lhr-solar/RTD_Array_Board/RTDTemp.kicad_sch

## KiCad design RTDTemp.kicad_sch (2022-02-08)

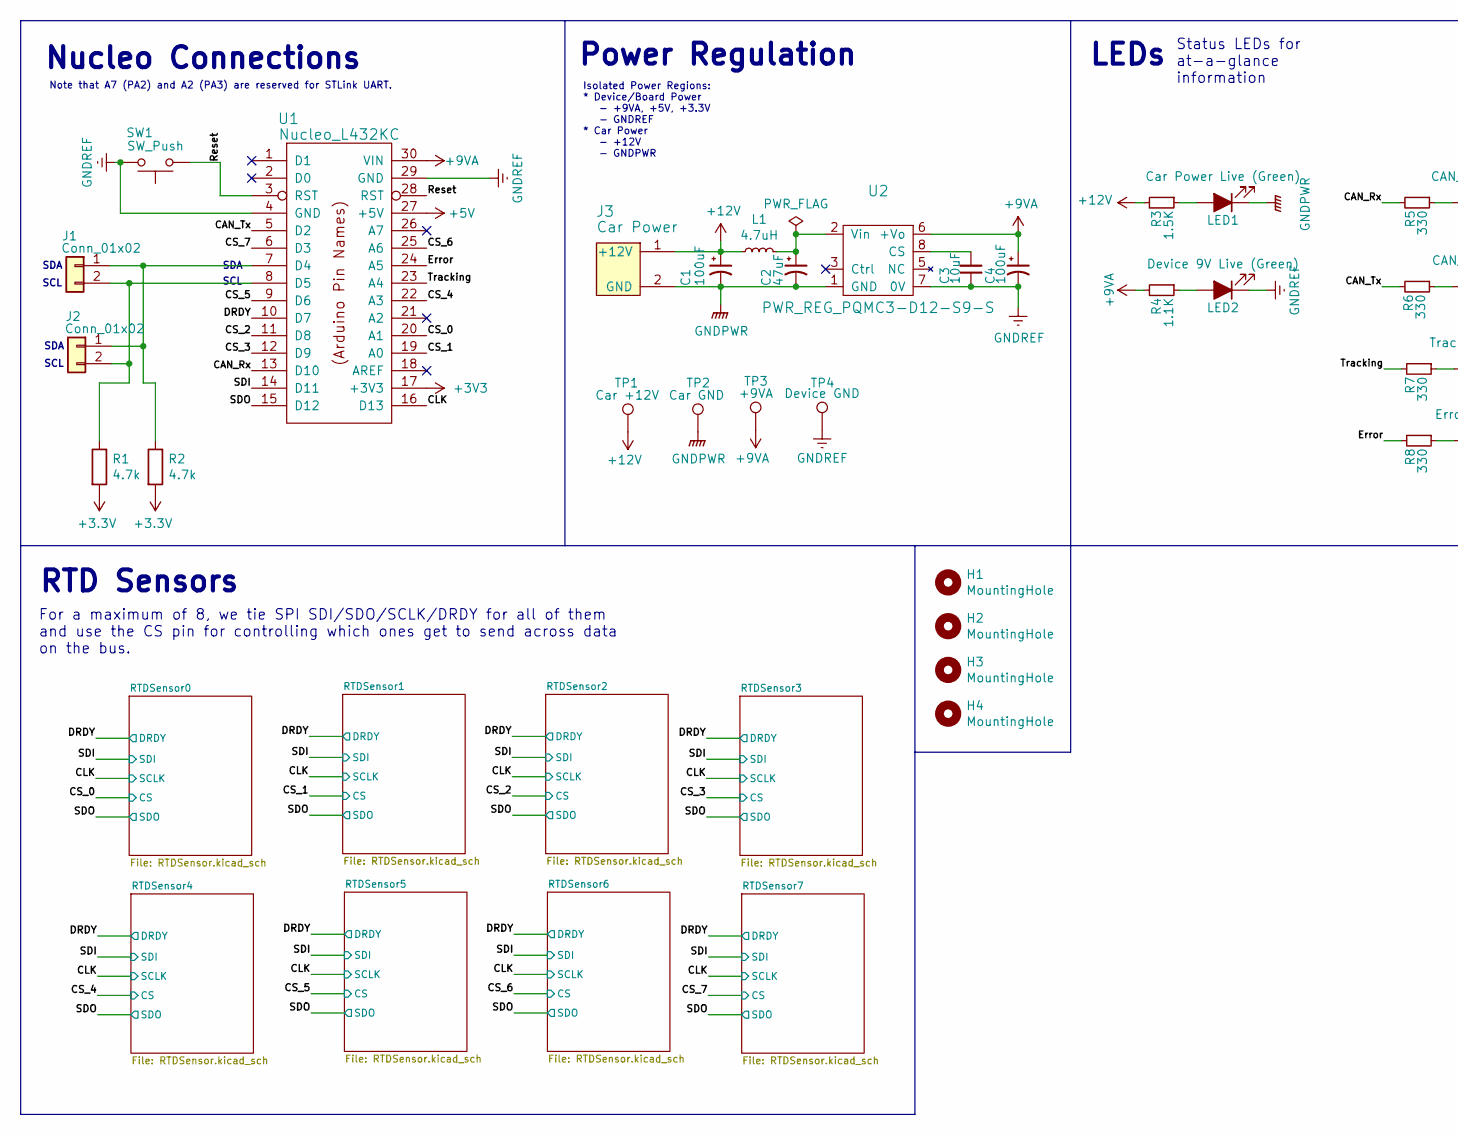
[picture p1: schematic RTDTemp.kicad_sch, part in row 1, column 1]

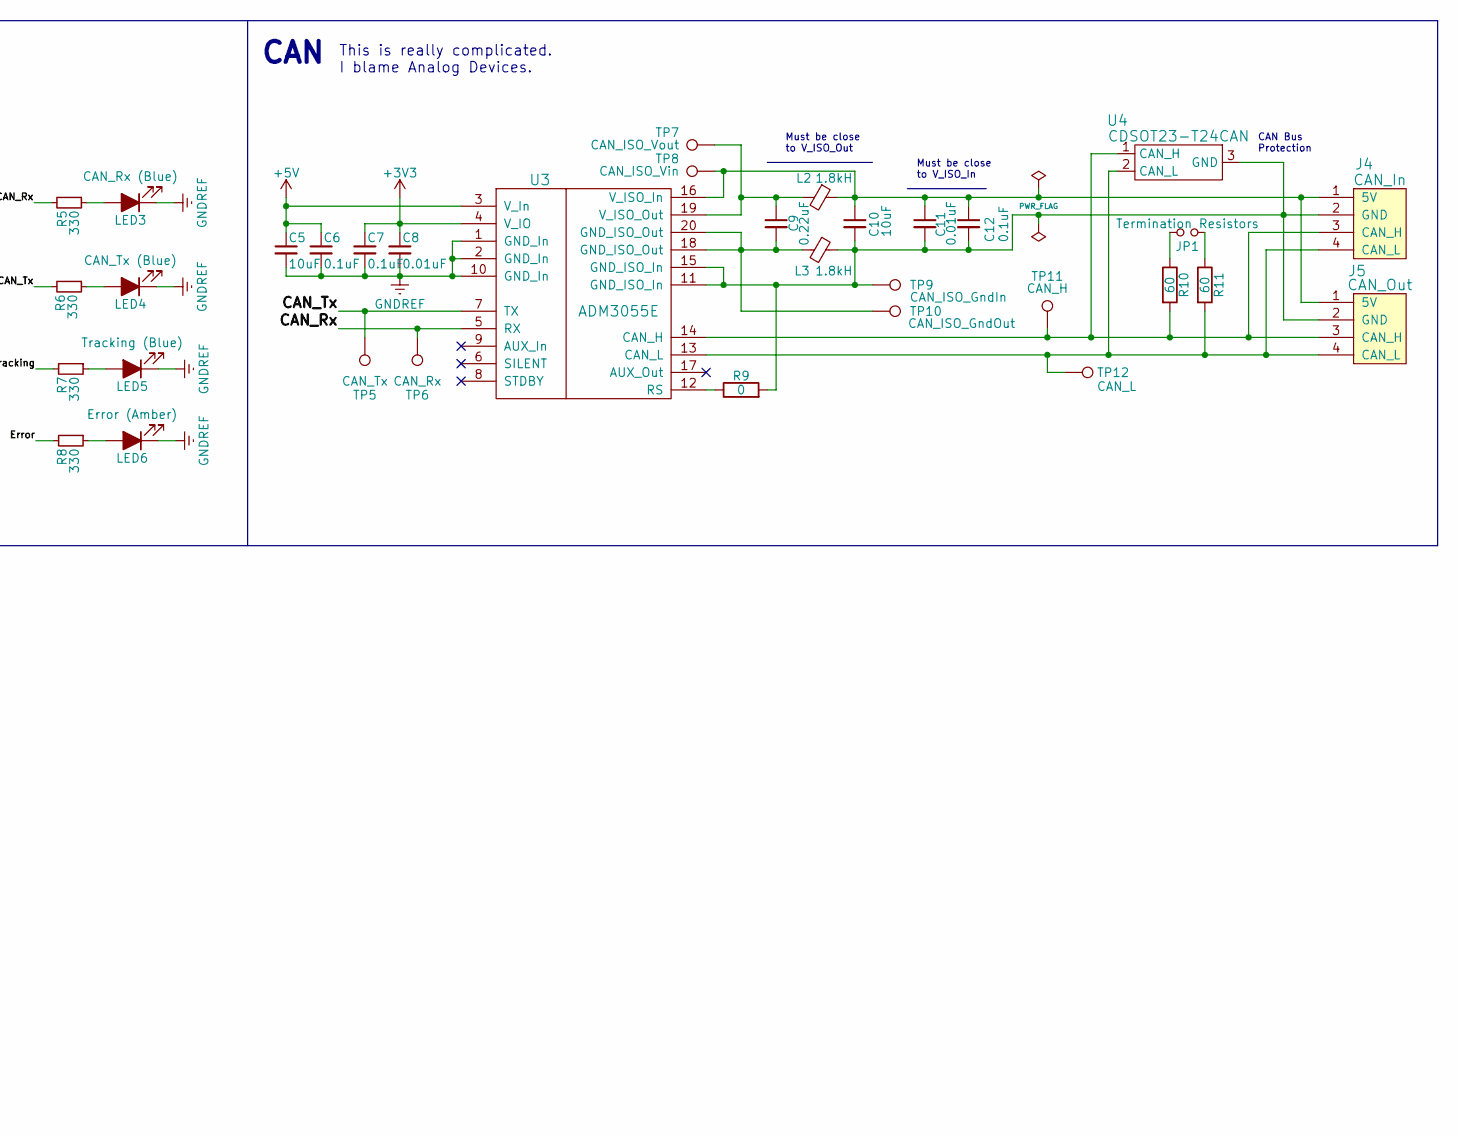
[picture p2: schematic RTDTemp.kicad_sch, part in row 1, column 2]

Parts:
C1, C4: 100uF; C_1210_3225Metric
C2: 47uF; C_1210_3225Metric
C3, C5, C10: 10uF; C_0805_2012Metric
C6, C7, C12: 0.1uF; C_0805_2012Metric
C8, C11: 0.01uF; C_0805_2012Metric
C9: 0.22uF; C_0805_2012Metric
H1, H2, H3, H4: MountingHole; MountingHole_3mm
J1, J2: Conn_01x02; Molex_Micro-Fit_3.0_43650-0215_1x02_P3.00mm_Vertical
J3: Car Power; Molex_Micro-Fit_3.0_43650-0215_1x02_P3.00mm_Vertical
J4: CAN_In; Molex_Micro-Fit_3.0_43650-0415_1x04_P3.00mm_Vertical
J5: CAN_Out; Molex_Micro-Fit_3.0_43650-0415_1x04_P3.00mm_Vertical
JP1: Termination Resistors; PinHeader_1x02_P2.54mm_Vertical
L1: 4.7uH; L_0805_2012Metric
L2, L3: 1.8kH; L_0805_2012Metric
LED1: Car Power Live (Green); LED_0805_2012Metric
LED2: Device 9V Live (Green); LED_0805_2012Metric
LED3: CAN_Rx (Blue); LED_0805_2012Metric
LED4: CAN_Tx (Blue); LED_0805_2012Metric
LED5: Tracking (Blue); LED_0805_2012Metric
LED6: Error (Amber); LED_0805_2012Metric
R1, R2: 4.7k; R_0805_2012Metric
R3: 1.5K; R_0805_2012Metric
R4: 1.1K; R_0805_2012Metric
R5, R6, R7, R8: 330; R_0805_2012Metric
R9: 0; R_0805_2012Metric
R10, R11: 60; R_0805_2012Metric
SW1: SW_Push; SW_PUSH_6mm
TP1: Car +12V; TestPoint_Keystone_5005-5009_Compact
TP2: Car GND; TestPoint_Keystone_5005-5009_Compact
TP3: +9VA; TestPoint_Keystone_5005-5009_Compact
TP4: Device GND; TestPoint_Keystone_5005-5009_Compact
TP5: CAN_Tx; TestPoint_Keystone_5005-5009_Compact
TP6: CAN_Rx; TestPoint_Keystone_5005-5009_Compact
TP7: CAN_ISO_Vout; TestPoint_Keystone_5005-5009_Compact
TP8: CAN_ISO_Vin; TestPoint_Keystone_5005-5009_Compact
TP9: CAN_ISO_GndIn; TestPoint_Keystone_5005-5009_Compact
TP10: CAN_ISO_GndOut; TestPoint_Keystone_5005-5009_Compact
TP11: CAN_H; TestPoint_Keystone_5005-5009_Compact
TP12: CAN_L; TestPoint_Keystone_5005-5009_Compact
U1: Nucleo_L432KC; MODULE_NUCLEO-L432KC
U2: PWR_REG_PQMC3-D12-S9-S; 490_PQMC3_D12_S12_S
U3: ADM3055E; ADM3055EBRIZ
U4: CDSOT23-T24CAN; SOT-23

Connections:
+3.3V: R1.2, R2.2
+3V3: C7.1, C8.1, U1.17 (+3V3), U3.4 (V_IO)
+5V: C5.1, C6.1, U1.27 (+5V), U3.3 (V_In)
+9VA: C4.1, R4.2, TP3.1, U1.30 (VIN), U2.6 (+Vo)
+12V: C1.1, J3.1 (+12V), L1.1, R3.2, TP1.1
CAN_Rx: R5.2, TP6.1, U1.13 (D10), U3.5 (RX)
CAN_Tx: R6.2, TP5.1, U1.5 (D2), U3.7 (TX)
CLK: U1.16 (D13)
CS_0: U1.20 (A1)
CS_1: U1.19 (A0)
CS_2: U1.11 (D8)
CS_3: U1.12 (D9)
CS_4: U1.22 (A3)
CS_5: U1.9 (D6)
CS_6: U1.25 (A6)
CS_7: U1.6 (D3)
DRDY: U1.10 (D7)
Error: R8.2, U1.24 (A5)
GNDPWR: C1.2, C2.2, J3.2 (GND), LED1.1 (K), TP2.1, U2.1 (GND)
GNDREF: C3.1, C4.2, C5.2, C6.2, C7.2, C8.2, LED2.1 (K), LED3.1 (K), LED4.1 (K), LED5.1 (K), LED6.1 (K), SW1.2, TP4.1, U1.4 (GND), U1.29 (GND), U2.7 (0V), U3.1 (GND_In), U3.2 (GND_In), U3.10 (GND_In)
unnamed: C2.1, L1.2, U2.2 (Vin)
unnamed: C3.2, U2.8 (CS)
unnamed: C9.1, L2.2, TP7.1, U3.19 (V_ISO_Out)
unnamed: C9.2, L3.2, TP10.1, U3.18 (GND_ISO_Out), U3.20 (GND_ISO_Out)
unnamed: C10.1, C11.1, C12.1, J4.1 (5V), J5.1 (5V), L2.1, TP8.1, U3.16 (V_ISO_In)
unnamed: C10.2, C11.2, C12.2, J4.2 (GND), J5.2 (GND), L3.1, R9.2, TP9.1, U3.11 (GND_ISO_In), U3.15 (GND_ISO_In), U4.3 (GND)
unnamed: J1.1, J2.1, R2.1, U1.7 (D4)
unnamed: J1.2, J2.2, R1.1, U1.8 (D5)
unnamed: J4.3 (CAN_H), J5.3 (CAN_H), R10.2, TP11.1, U3.14 (CAN_H), U4.1 (CAN_H)
unnamed: J4.4 (CAN_L), J5.4 (CAN_L), R11.2, TP12.1, U3.13 (CAN_L), U4.2 (CAN_L)
unnamed: JP1.1, R11.1
unnamed: JP1.2, R10.1
unnamed: LED1.2 (A), R3.1
unnamed: LED2.2 (A), R4.1
unnamed: LED3.2 (A), R5.1
unnamed: LED4.2 (A), R6.1
unnamed: LED5.2 (A), R7.1
unnamed: LED6.2 (A), R8.1
unnamed: R9.1, U3.12 (RS)
Reset: SW1.1, U1.3 (RST), U1.28 (RST)
SDI: U1.14 (D11)
SDO: U1.15 (D12)
Tracking: R7.2, U1.23 (A4)

Notes on the sheet:
RTD Sensors
Must be close to V_ISO_Out
SCL
Status LEDs for at-a-glance information
For a maximum of 8, we tie SPI SDI/SDO/SCLK/DRDY for all of them and use the CS pin for controlling which ones get to send across data on the bus.
SDA
Isolated Power Regions: * Device/Board Power - +9VA, +5V, +3.3V - GNDREF * Car Power - +12V - GNDPWR
CAN Bus Protection
This is really complicated. I blame Analog Devices.
Power Regulation
CAN
Must be close to V_ISO_In
Nucleo Connections
Note that A7 (PA2) and A2 (PA3) are reserved for STLink UART.
LEDs
